AdamWelchUK/PWM85/3.3v/PWM85_3.3v_PCB_Capture.PNG

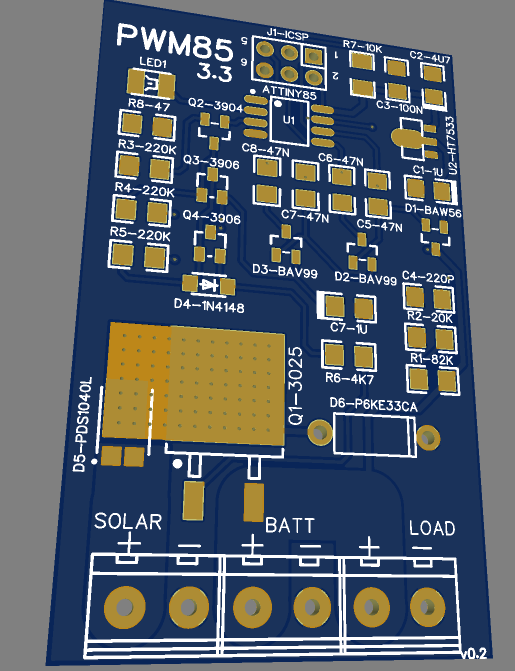
3.3v/PWM85_3.3v_PCB_Capture.PNG
