AdamWelchUK/PWM85/5v/PWM85_5v_PCB_Capture.PNG

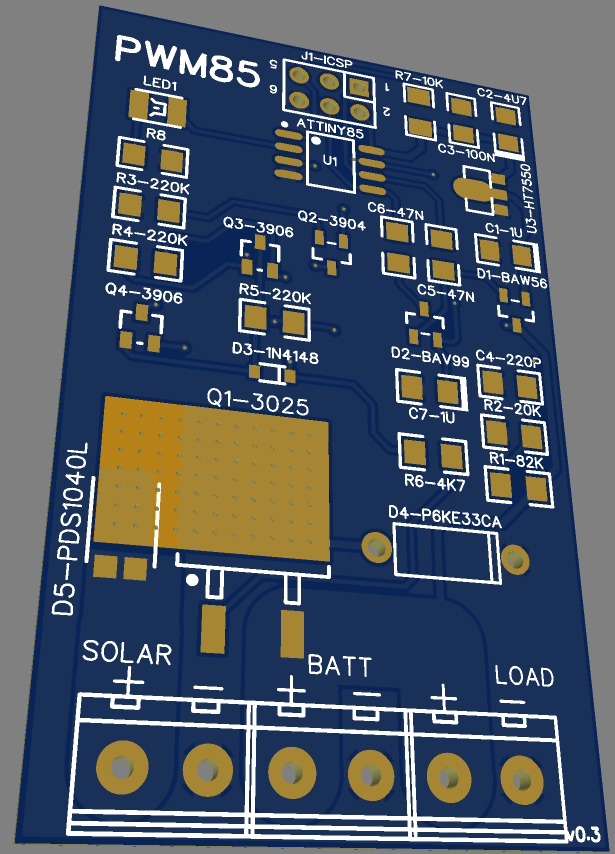
5v/PWM85_5v_PCB_Capture.PNG
