AdamWelchUK/PWM85/5v/PWM85_5v_BOM.csv

ID | Name | Designator | Footprint | Quantity | Manufacturer Part | Manufacturer | Supplier | Supplier Part | LCSC Assembly
1 | P6KE33CA | D4-P6KE33CA | DO-15 | 1 | P6KE33CA | Brightking | LCSC | C84734
2 | 220k | R4-220K,R3-220K,R5-220K | 1206 | 3 | NKNP 1/2W 0.92Ω±5% T | CCO | LCSC | C138369
3 | 4k7 | R6-4K7 | 1206 | 1 | NKNP 1/2W 0.92Ω±5% T | CCO | LCSC | C138369
4 | 1k | R8 | 1206 | 1 | NKNP 1/2W 0.92Ω±5% T | CCO | LCSC | C138369
5 | 10k | R7-10K | 1206 | 1 | ?
6 | CON_HEADER_PRG_AVR_ICSP | J1-ICSP | HEADER_PRG_2X03 | 1
7 | HT7550-1 | U3-HT7550 | SOT-89 | 1 | HT7550-1 | HOLTEK | LCSC | C16106 | Yes
8 | BAV99-E3-08 | D2-BAV99 | SOT-23-3 | 1 | BAV99-E3-08 | VISHAY | LCSC | C78252
9 | 20k 1% | R2-20K | 1206 | 1 | ?
10 | 82k 1% | R1-82K | 1206 | 1 | ?
11 | BAW56-E3-08 | D1-BAW56 | SOT-23(SOT-23-3) | 1 | BAW56-E3-08 | VISHAY | LCSC | C142604
12 | IRF3205STRLPBF | Q1-3025 | TO-263-2 | 1 | IRF3205STRLPBF | IR | LCSC | C2613
13 | ATTINY45-20SUR | U1 | SOIC-8_208MIL | 1 | ATTINY45-20SUR | MICROCHIP | LCSC | C152211
14 | PDS1040L-13 | D5-PDS1040L | POWERDI-5_L5.4-W4.0-LS6.5-RD | 1 | PDS1040L-13 | DIODES | LCSC | C154714
15 | 1u 25v | C1-1U,C7-1U | 1206 | 2 | ?
16 | 4u7 | C2-4U7 | 1206 | 1 | ?
17 | LEDBlue light | LED1 | LED-SMD_L3.6-W2.9-R-RD | 1 | LEDBlue light | ReliaPro | LCSC | C69273 | Yes
18 | WJ301V-5.0-2P | SOLAR,BATT,LOAD | WJ301V-5.00-2P | 3 | WJ301V-5.0-2P | ReliaPro | LCSC | C8475
19 | MMBT3904 | Q2-3904 | SOT-23(SOT-23-3) | 1 | MMBT3904 | PANJIT | LCSC | C124752
20 | MMBT3906T | Q3-3906,Q4-3906 | SOT-23 | 2 | MMBT3906T | CJ | LCSC | C61615
21 | 1N4148WS-E3-08 | D3-1N4148 | SOD-323-F | 1 | 1N4148WS-E3-08 | VISHAY | LCSC | C129905
22 | 47n | C5-47N,C6-47N | 1206 | 2 | ?
23 | 100n | C3-100N | 1206 | 1 | ?
24 | 220p | C4-220P | 1206 | 1 | ?
