AdamWelchUK/PWM85/5v/PWM85_5v_Schematic.pdf

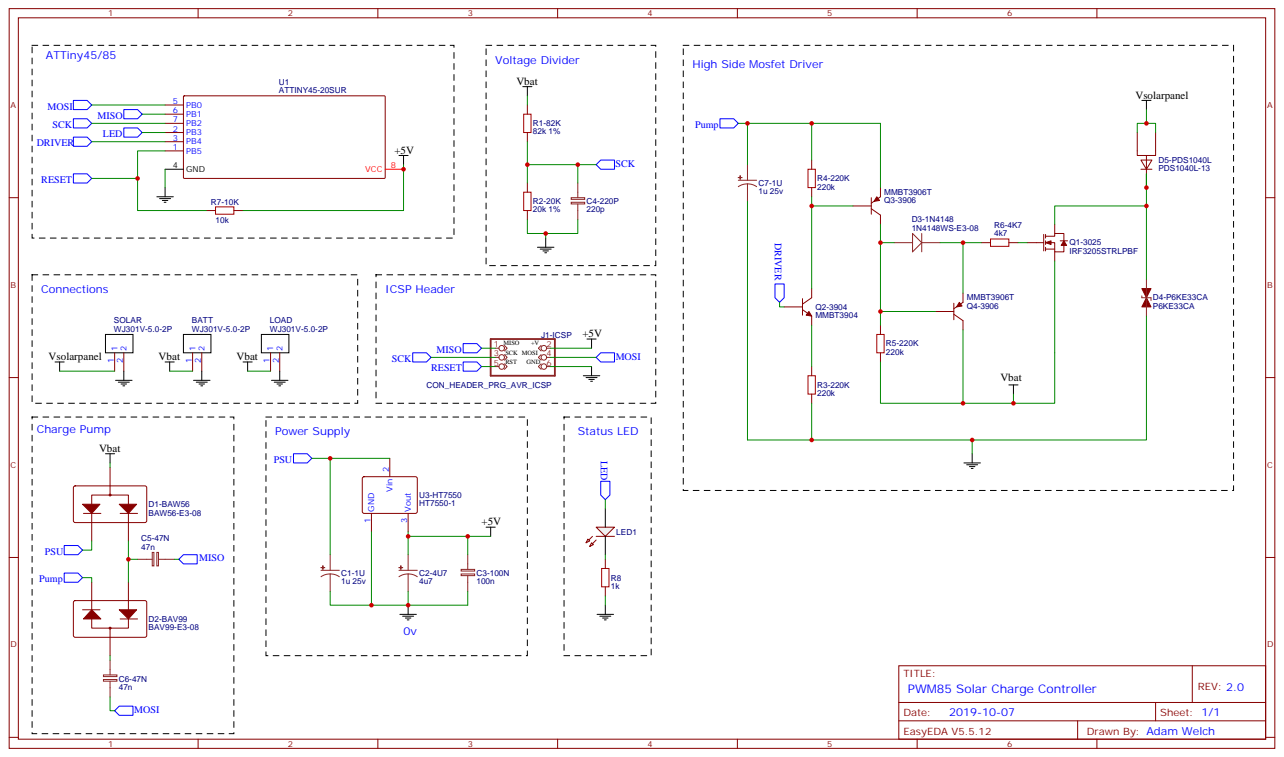
[picture p3: page 1]

High Side Mosfet Driver
