AdamWelchUK/PWM85/3.3v/PWM85_3.3v_Schematic.pdf

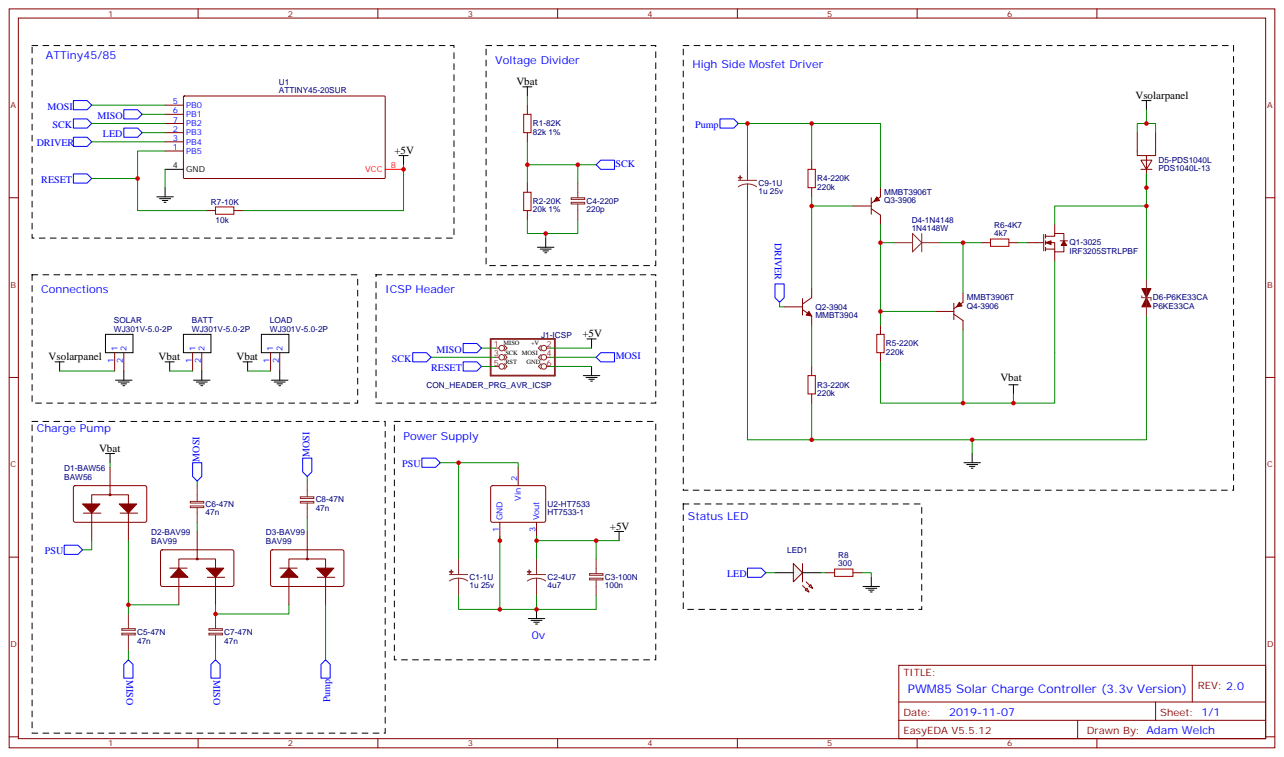
[picture p4: page 1]

High Side Mosfet Driver

TITLE:
PWM85 Solar Charge Controller (3.3v Version)
