AdamWelchUK/PWM85/(commit log)

2020-02-18 Update README.md
    Added column for 3.3v components
2020-02-20 Update PWM85.ino
    Added
    - pinMode setup for all pins
    - PRR handling
    - Sleep instead of delay(10)
2020-02-20 Adding watchdog sleep and other minor changes
    * Adding ATtiny schematic in header comments
    * Disabling USI in PRR -> Around 5µA reduction (3.3V@1MHz)
    * Also adding pinMode setup for all pins -> Correct unwanted LED behavior at startup
    * And making a watchdog sleep (idle) instead of "delay(10)" -> Around 100µA reduction (3.3V@1MHz)
    [PWM85.ino]
2020-02-26 Update PWM85.ino
    Tidied code and improved some comments.
2020-02-26 Update README.md
    Increased rating on 1uF tantalum on input to allow for 16v+ battery voltage.
2020-02-28 Update PWM85.ino
    Disable ADC and ADC module while asleep
2020-02-28 Sleep Mode IDLE error #1
    May help on first run
    [PWM85.ino]
2020-02-28 Sleep Mode IDLE error #2
    On ATTinyCore, choose millis()/micros() disabled
    [PWM85.ino]
2020-03-01 Timer/Counters 0 change
    Swap analogWrite() call to simpler direct register change
    [PWM85.ino]
2020-03-01 Timer/Counter 1 change
    Change in GTCCR : activate complementary output.
    Keep in mind here's only one counter to rule both output.
    Again, direct register change instead of analogWrite() call.
2020-03-01 Moved power_adc_disable()
    Moved power_adc_disable() stuff closer to where it's used : just before and after analogRead() call.
2020-03-04 Error correction in rewrite
    Corrected some bad typos
    [PWM85.ino]
2020-03-04 Fine power handling
    Shut Timer0/1 when possible.
    Use of PWR_DOWN sleep mode
2020-03-05 Removed Timer0/1 on the fly handling
    To get rid of odd behaviours
2020-03-11 Basic test rewrite
    Also correct possible error when stepSize > 1
    [PWM85.ino]
2021-04-06 Delete PWM85.h
    Remove need for two files
2021-04-06 Update PWM85.ino
    Rremove need for two files
2021-04-06 Update PWM85.ino
    Updeated instructions
